ALumineMotus/LED_Cube_8x8x8_Mini/0_Documentation/Datasheet/Recto_verso_arduino_nano.jpg

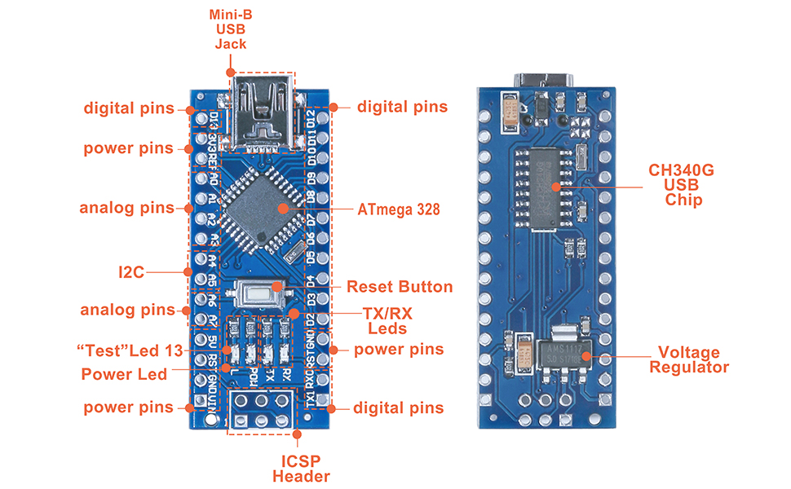
0_Documentation/Datasheet/Recto_verso_arduino_nano.jpg
