ALumineMotus/LED_Cube_8x8x8_Mini/1_Hardware/Cube_8x8x8_Mini_LED_Grid_08/Cube_Mini_8x8x8_LED_Grid_top_bom_NH-B1010RGBT-HF.csv

Comment | Designator | Footprint | LCSC Part #
NH-B1010RGBT-HF | U$1 | LED-ARRAY-SMD_4P-L1.0-W1.0-TR_NH-B1010RGBT | C2874113
NH-B1010RGBT-HF | U$2 | LED-ARRAY-SMD_4P-L1.0-W1.0-TR_NH-B1010RGBT | C2874113
NH-B1010RGBT-HF | U$3 | LED-ARRAY-SMD_4P-L1.0-W1.0-TR_NH-B1010RGBT | C2874113
NH-B1010RGBT-HF | U$4 | LED-ARRAY-SMD_4P-L1.0-W1.0-TR_NH-B1010RGBT | C2874113
NH-B1010RGBT-HF | U$5 | LED-ARRAY-SMD_4P-L1.0-W1.0-TR_NH-B1010RGBT | C2874113
NH-B1010RGBT-HF | U$6 | LED-ARRAY-SMD_4P-L1.0-W1.0-TR_NH-B1010RGBT | C2874113
NH-B1010RGBT-HF | U$7 | LED-ARRAY-SMD_4P-L1.0-W1.0-TR_NH-B1010RGBT | C2874113
NH-B1010RGBT-HF | U$8 | LED-ARRAY-SMD_4P-L1.0-W1.0-TR_NH-B1010RGBT | C2874113
NH-B1010RGBT-HF | U$9 | LED-ARRAY-SMD_4P-L1.0-W1.0-TR_NH-B1010RGBT | C2874113
NH-B1010RGBT-HF | U$10 | LED-ARRAY-SMD_4P-L1.0-W1.0-TR_NH-B1010RGBT | C2874113
NH-B1010RGBT-HF | U$11 | LED-ARRAY-SMD_4P-L1.0-W1.0-TR_NH-B1010RGBT | C2874113
NH-B1010RGBT-HF | U$12 | LED-ARRAY-SMD_4P-L1.0-W1.0-TR_NH-B1010RGBT | C2874113
NH-B1010RGBT-HF | U$13 | LED-ARRAY-SMD_4P-L1.0-W1.0-TR_NH-B1010RGBT | C2874113
NH-B1010RGBT-HF | U$14 | LED-ARRAY-SMD_4P-L1.0-W1.0-TR_NH-B1010RGBT | C2874113
NH-B1010RGBT-HF | U$15 | LED-ARRAY-SMD_4P-L1.0-W1.0-TR_NH-B1010RGBT | C2874113
NH-B1010RGBT-HF | U$16 | LED-ARRAY-SMD_4P-L1.0-W1.0-TR_NH-B1010RGBT | C2874113
NH-B1010RGBT-HF | U$17 | LED-ARRAY-SMD_4P-L1.0-W1.0-TR_NH-B1010RGBT | C2874113
NH-B1010RGBT-HF | U$18 | LED-ARRAY-SMD_4P-L1.0-W1.0-TR_NH-B1010RGBT | C2874113
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
NH-B1010RGBT-HF | U$62 | LED-ARRAY-SMD_4P-L1.0-W1.0-TR_NH-B1010RGBT | C2874113
NH-B1010RGBT-HF | U$63 | LED-ARRAY-SMD_4P-L1.0-W1.0-TR_NH-B1010RGBT | C2874113
NH-B1010RGBT-HF | U$64 | LED-ARRAY-SMD_4P-L1.0-W1.0-TR_NH-B1010RGBT | C2874113
