ALumineMotus/LED_Cube_8x8x8_Mini/3_Meca/glass_side_large.SLDPRT

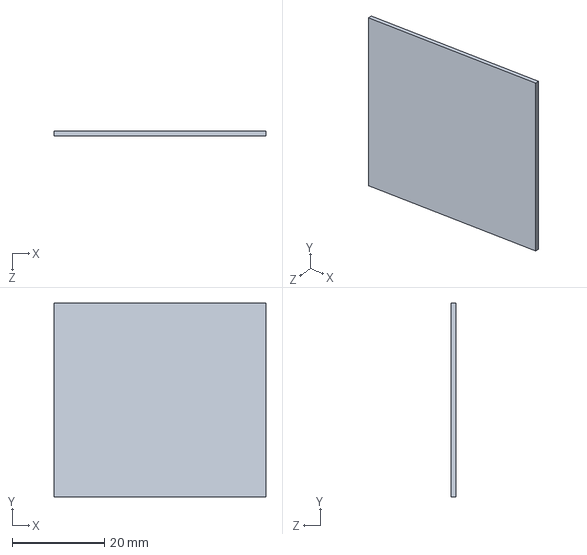
[picture p2: CAD file, 2024-05-30]
3_Meca/glass_side_large.SLDPRT
46.0 x 42.0 x 1.00 mm
