ALumineMotus/LED_Cube_8x8x8_Mini/3_Meca/glass_side_top.SLDPRT

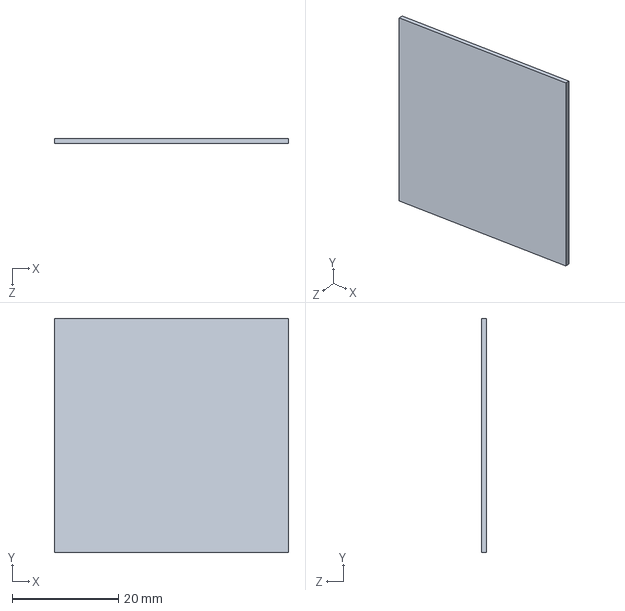
[picture p3: CAD file, 2024-05-30]
3_Meca/glass_side_top.SLDPRT
44.0 x 44.0 x 1.00 mm
