ALumineMotus/LED_Cube_8x8x8_Mini/3_Meca/glass_side_small.SLDPRT

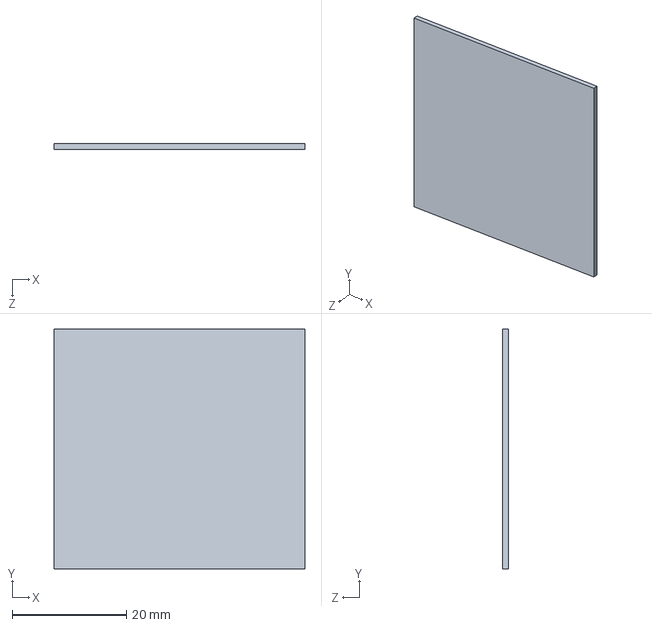
[picture p4: CAD file, 2024-05-30]
3_Meca/glass_side_small.SLDPRT
44.0 x 42.0 x 1.00 mm
