ALumineMotus/LED_Cube_8x8x8_Mini/3_Meca/case.SLDPRT

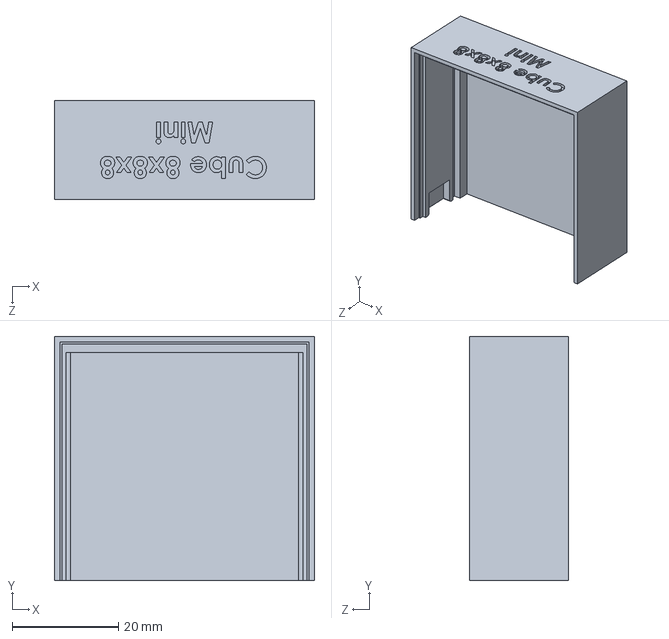
[picture p5: CAD file, 2024-01-14]
3_Meca/case.SLDPRT
49.0 x 46.0 x 18.6 mm
