ALumineMotus/LED_Cube_8x8x8_Mini/3_Meca/backside.SLDPRT

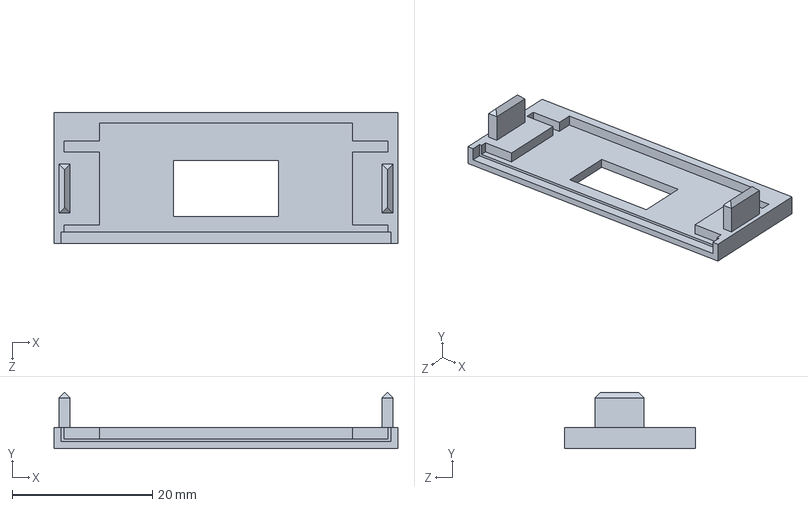
[picture p6: CAD file, 2024-01-14]
3_Meca/backside.SLDPRT
49.0 x 8.00 x 18.6 mm
