ALumineMotus/LED_Cube_8x8x8_Mini/3_Meca/cale.SLDPRT

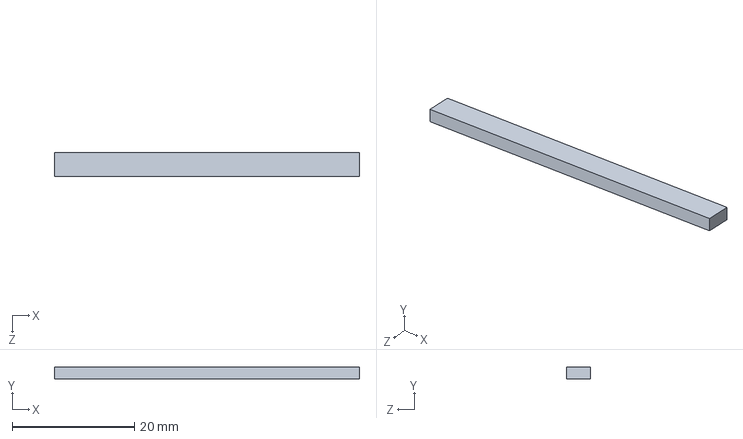
[picture p7: CAD file, 2024-01-14]
3_Meca/cale.SLDPRT
50.0 x 2.00 x 4.00 mm
