ALumineMotus/LED_Cube_8x8x8_Mini/(list of files, cad)

Other CAD files:
3_Meca/backside.STL
3_Meca/cale.STL
3_Meca/case.STL
3_Meca/glass_side_large.dxf
3_Meca/glass_side_small.dxf
3_Meca/glass_side_top.dxf
