ALumineMotus/LED_Cube_8x8x8_Mini/0_Documentation/Schematic/Cube_8x8x8_Mini_LED_Base_Schematic.pdf

A

A

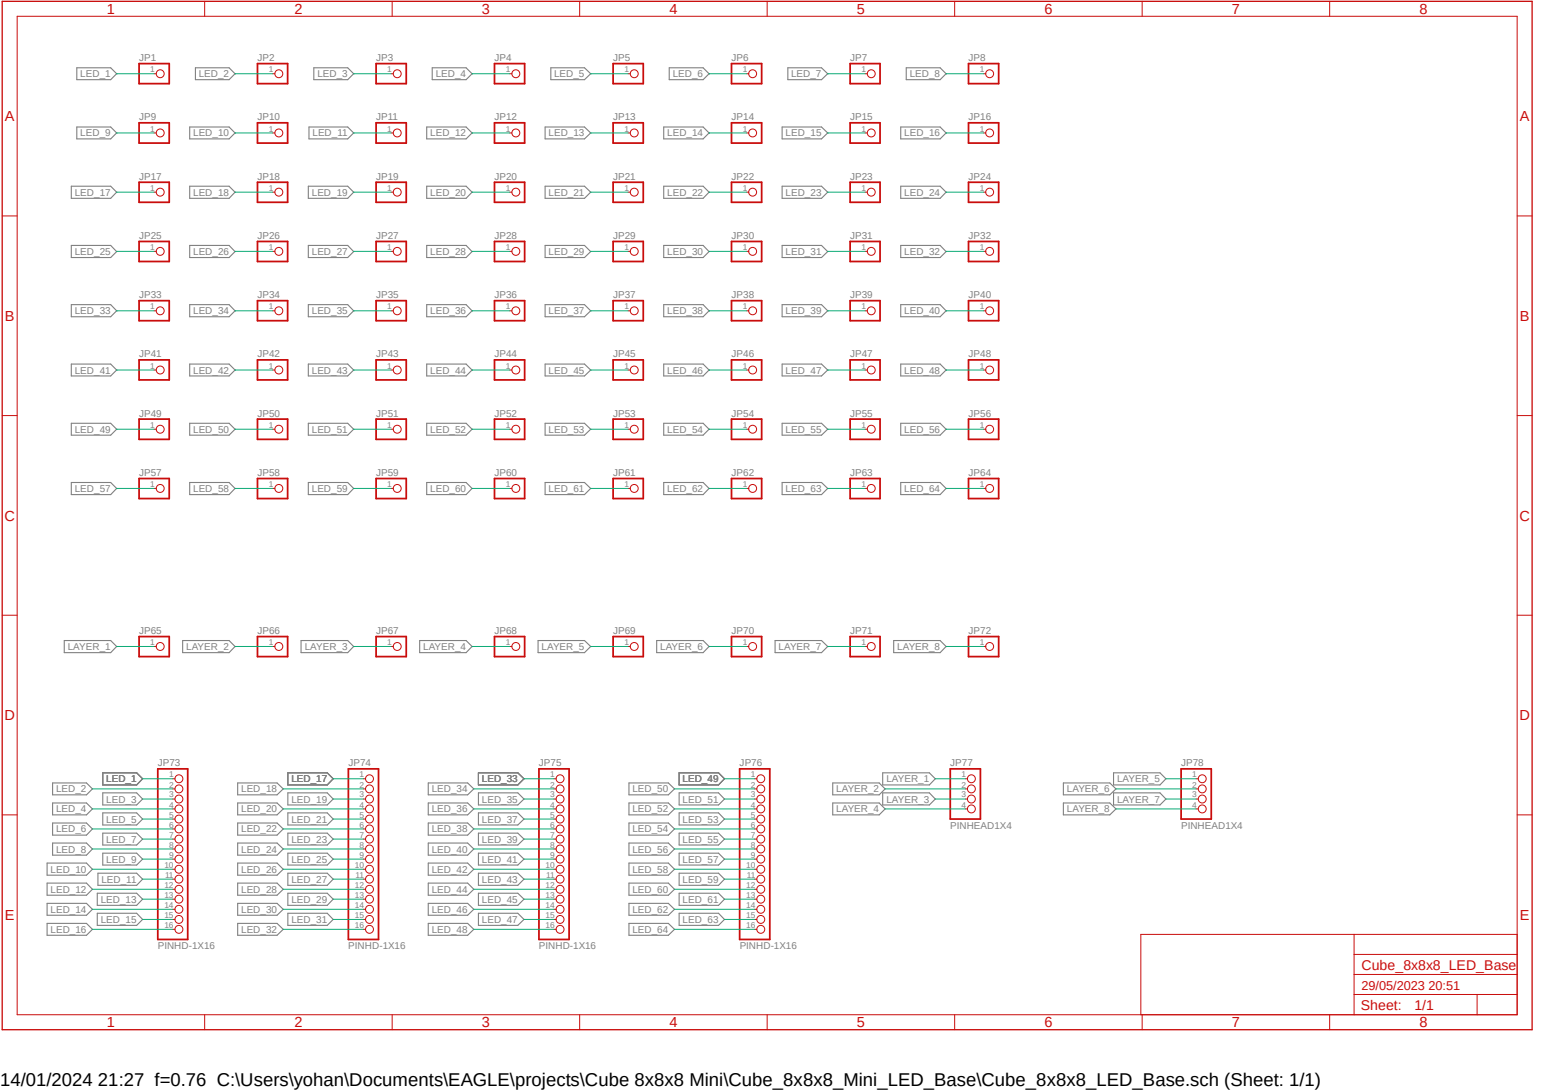
[picture p9: page 1]

14/01/2024 21:27 f=0.76 C:\Users\yohan\Documents\EAGLE\projects\Cube 8x8x8 Mini\Cube_8x8x8_Mini_LED_Base\Cube_8x8x8_LED_Base.sch (Sheet: 1/1)
