ALumineMotus/LED_Cube_8x8x8_Mini/0_Documentation/Schematic/Cube_8x8x8_Mini_LED_Grid_08_Schematic.pdf

A

B

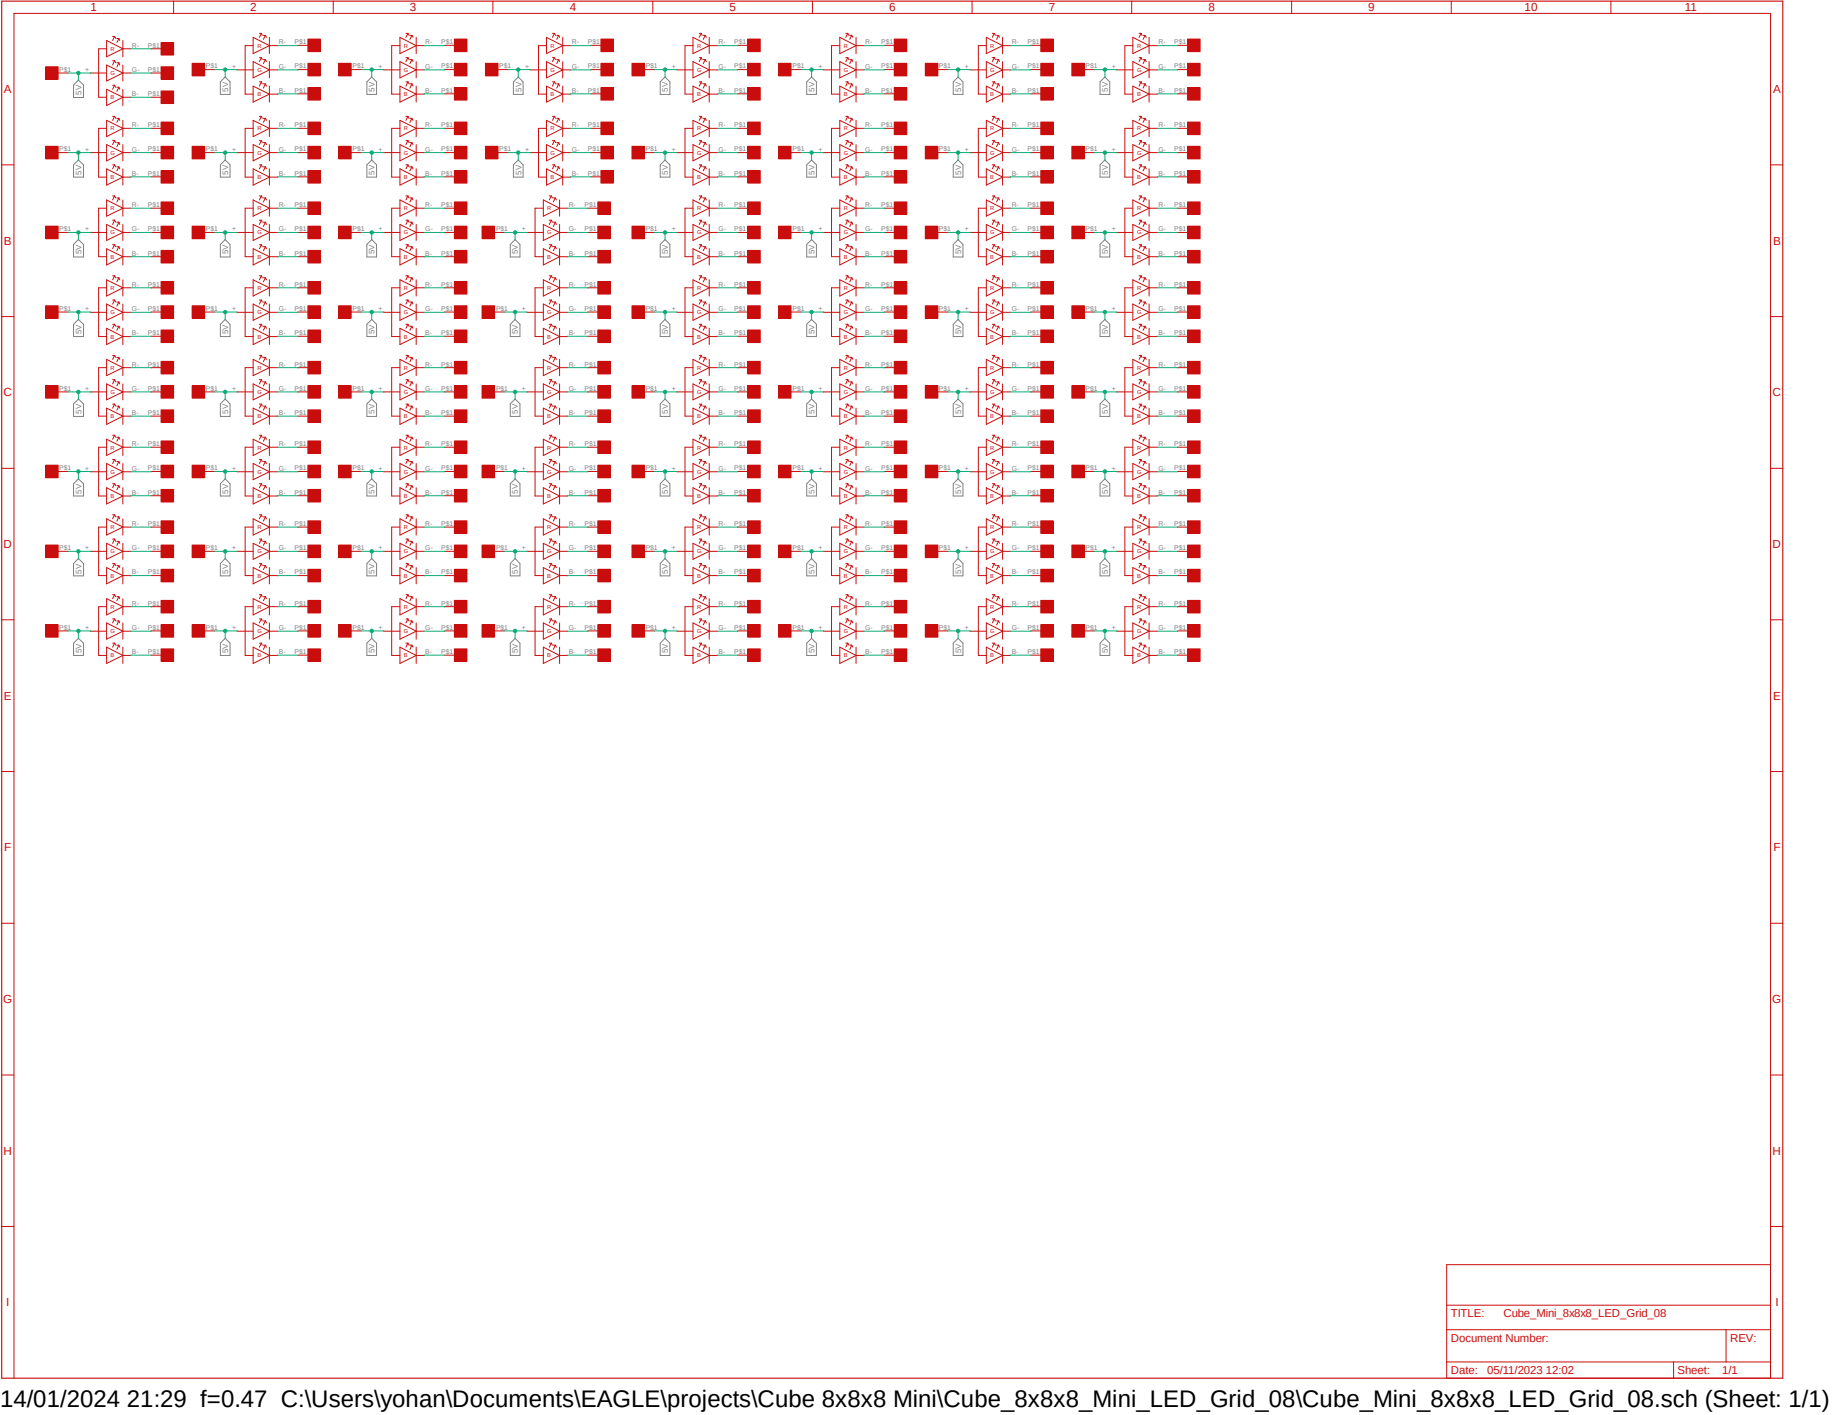
[picture p10: page 1]
TITLE:; Cube_Mini_8x8x8_LED_Grid_08

Document Number: | REV:

Date: 05/11/2023 12:02 | Sheet: 1/1

14/01/2024 21:29 f=0.47 C:\Users\yohan\Documents\EAGLE\projects\Cube 8x8x8 Mini\Cube_8x8x8_Mini_LED_Grid_08\Cube_Mini_8x8x8_LED_Grid_08.sch (Sheet: 1/1)
