ALumineMotus/LED_Cube_8x8x8_Mini/1_Hardware/Fail/Cube 8x8x8 Mini - Control - Copie/Cube_8x8x8_Mini_Control.brd

## EAGLE design 1_Hardware/Fail/Cube 8x8x8 Mini - Control - Copie/Cube_8x8x8_Mini_Control.brd (2024-05-30)

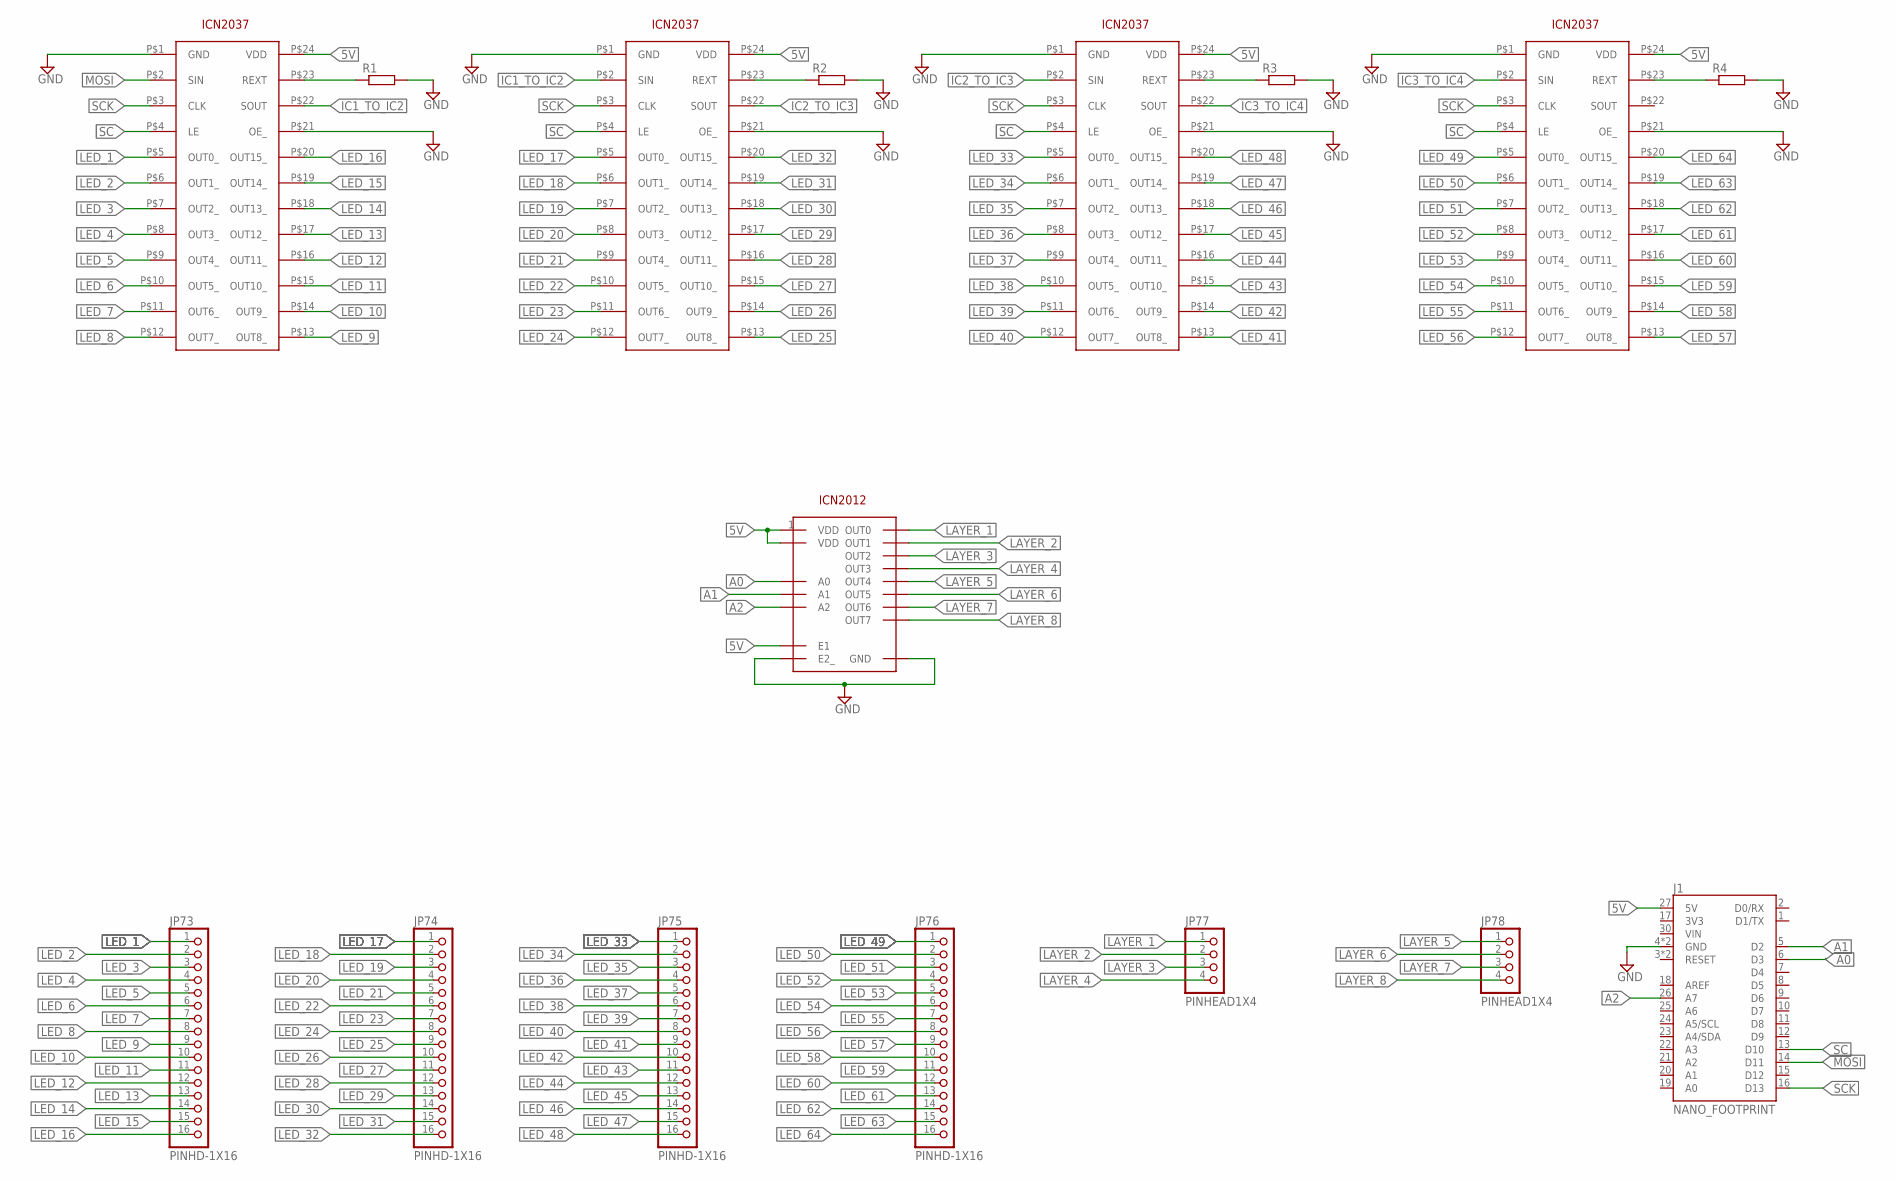
[picture p11: schematic Cube_8x8x8_Mini_Control.sch]

Parts:
J1: NANO_FOOTPRINT; NANO
JP73, JP74, JP75, JP76: PINHD-1X16; 2X16
JP77, JP78: PINHEAD1X4; 2X04
R1, R2, R3, R4: R-EU_R1206; R1206
U1, U2, U3, U4: ICN2037; SSOP24-P-150-0.635
U5: ICN2012; SOP16

Connections:
5V: J1.27 (5V), U1.P$24 (VDD), U2.P$24 (VDD), U3.P$24 (VDD), U4.P$24 (VDD), U5.1 (VDD), U5.7 (E1), U5.9 (VDD)
A0: J1.6 (D3), U5.15 (A0)
A1: J1.5 (D2), U5.16 (A1)
A2: J1.26 (A7), U5.2 (A2)
GND: J1.4 (GND), J1.29 (GND), R1.2, R2.2, R3.2, R4.2, U1.P$1 (GND), U1.P$21 (OE_), U2.P$1 (GND), U2.P$21 (OE_), U3.P$1 (GND), U3.P$21 (OE_), U4.P$1 (GND), U4.P$21 (OE_), U5.8 (GND), U5.10 (E2_)
IC1_TO_IC2: U1.P$22 (SOUT), U2.P$2 (SIN)
IC2_TO_IC3: U2.P$22 (SOUT), U3.P$2 (SIN)
IC3_TO_IC4: U3.P$22 (SOUT), U4.P$2 (SIN)
LAYER_1: JP77.1, U5.3 (OUT0)
LAYER_2: JP77.2, U5.4 (OUT1)
LAYER_3: JP77.3, U5.5 (OUT2)
LAYER_4: JP77.4, U5.6 (OUT3)
LAYER_5: JP78.1, U5.11 (OUT4)
LAYER_6: JP78.2, U5.12 (OUT5)
LAYER_7: JP78.3, U5.13 (OUT6)
LAYER_8: JP78.4, U5.14 (OUT7)
LED_1: JP73.1, U1.P$5 (OUT0_)
LED_2: JP73.2, U1.P$6 (OUT1_)
LED_3: JP73.3, U1.P$7 (OUT2_)
LED_4: JP73.4, U1.P$8 (OUT3_)
LED_5: JP73.5, U1.P$9 (OUT4_)
LED_6: JP73.6, U1.P$10 (OUT5_)
LED_7: JP73.7, U1.P$11 (OUT6_)
LED_8: JP73.8, U1.P$12 (OUT7_)
LED_9: JP73.9, U1.P$13 (OUT8_)
LED_10: JP73.10, U1.P$14 (OUT9_)
LED_11: JP73.11, U1.P$15 (OUT10_)
LED_12: JP73.12, U1.P$16 (OUT11_)
LED_13: JP73.13, U1.P$17 (OUT12_)
LED_14: JP73.14, U1.P$18 (OUT13_)
LED_15: JP73.15, U1.P$19 (OUT14_)
LED_16: JP73.16, U1.P$20 (OUT15_)
LED_17: JP74.1, U2.P$5 (OUT0_)
LED_18: JP74.2, U2.P$6 (OUT1_)
LED_19: JP74.3, U2.P$7 (OUT2_)
LED_20: JP74.4, U2.P$8 (OUT3_)
LED_21: JP74.5, U2.P$9 (OUT4_)
LED_22: JP74.6, U2.P$10 (OUT5_)
LED_23: JP74.7, U2.P$11 (OUT6_)
LED_24: JP74.8, U2.P$12 (OUT7_)
LED_25: JP74.9, U2.P$13 (OUT8_)
LED_26: JP74.10, U2.P$14 (OUT9_)
LED_27: JP74.11, U2.P$15 (OUT10_)
LED_28: JP74.12, U2.P$16 (OUT11_)
LED_29: JP74.13, U2.P$17 (OUT12_)
LED_30: JP74.14, U2.P$18 (OUT13_)
LED_31: JP74.15, U2.P$19 (OUT14_)
LED_32: JP74.16, U2.P$20 (OUT15_)
LED_33: JP75.1, U3.P$5 (OUT0_)
LED_34: JP75.2, U3.P$6 (OUT1_)
LED_35: JP75.3, U3.P$7 (OUT2_)
LED_36: JP75.4, U3.P$8 (OUT3_)
LED_37: JP75.5, U3.P$9 (OUT4_)
LED_38: JP75.6, U3.P$10 (OUT5_)
LED_39: JP75.7, U3.P$11 (OUT6_)
LED_40: JP75.8, U3.P$12 (OUT7_)
LED_41: JP75.9, U3.P$13 (OUT8_)
LED_42: JP75.10, U3.P$14 (OUT9_)
LED_43: JP75.11, U3.P$15 (OUT10_)
LED_44: JP75.12, U3.P$16 (OUT11_)
LED_45: JP75.13, U3.P$17 (OUT12_)
LED_46: JP75.14, U3.P$18 (OUT13_)
LED_47: JP75.15, U3.P$19 (OUT14_)
LED_48: JP75.16, U3.P$20 (OUT15_)
LED_49: JP76.1, U4.P$5 (OUT0_)
LED_50: JP76.2, U4.P$6 (OUT1_)
LED_51: JP76.3, U4.P$7 (OUT2_)
LED_52: JP76.4, U4.P$8 (OUT3_)
LED_53: JP76.5, U4.P$9 (OUT4_)
LED_54: JP76.6, U4.P$10 (OUT5_)
LED_55: JP76.7, U4.P$11 (OUT6_)
LED_56: JP76.8, U4.P$12 (OUT7_)
LED_57: JP76.9, U4.P$13 (OUT8_)
LED_58: JP76.10, U4.P$14 (OUT9_)
LED_59: JP76.11, U4.P$15 (OUT10_)
LED_60: JP76.12, U4.P$16 (OUT11_)
LED_61: JP76.13, U4.P$17 (OUT12_)
LED_62: JP76.14, U4.P$18 (OUT13_)
LED_63: JP76.15, U4.P$19 (OUT14_)
LED_64: JP76.16, U4.P$20 (OUT15_)
MOSI: J1.14 (D11), U1.P$2 (SIN)
unnamed: R1.1, U1.P$23 (REXT)
unnamed: R2.1, U2.P$23 (REXT)
unnamed: R3.1, U3.P$23 (REXT)
unnamed: R4.1, U4.P$23 (REXT)
SC: J1.13 (D10), U1.P$4 (LE), U2.P$4 (LE), U3.P$4 (LE), U4.P$4 (LE)
SCK: J1.16 (D13), U1.P$3 (CLK), U2.P$3 (CLK), U3.P$3 (CLK), U4.P$3 (CLK)

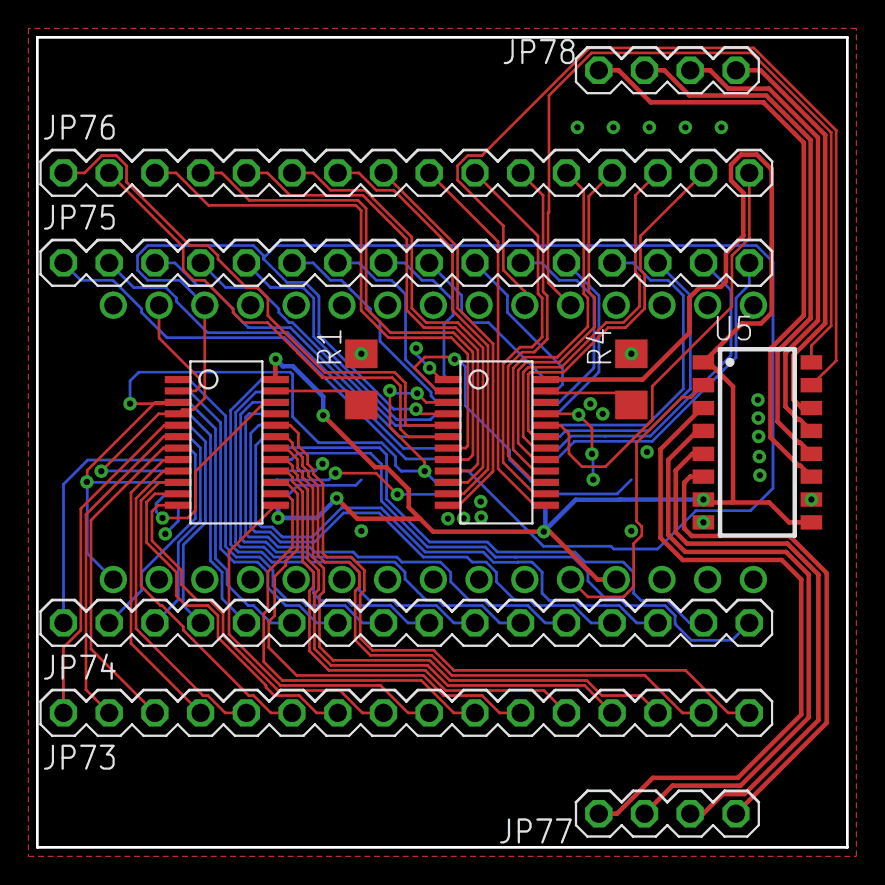
[picture p12: board Cube_8x8x8_Mini_Control.brd from above]

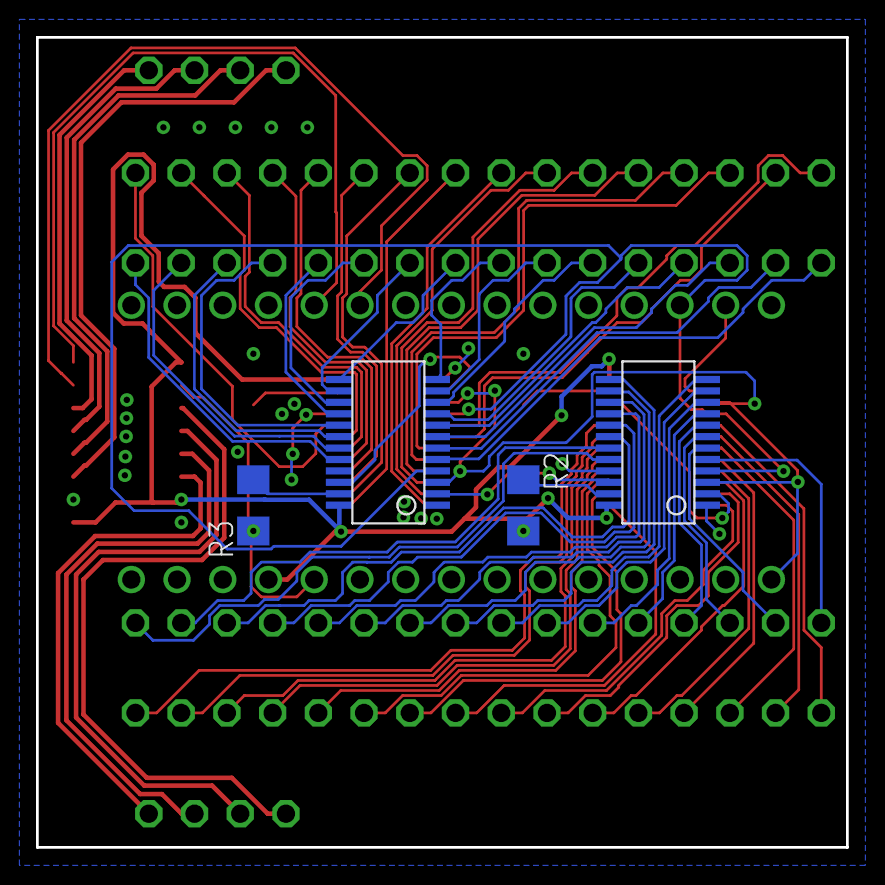
[picture p13: board Cube_8x8x8_Mini_Control.brd from below]

Board: 2 copper layers, 45.0 x 45.0 mm, 16 parts (4 on the bottom side), 87 nets.
