ALumineMotus/LED_Cube_8x8x8_Mini/1_Hardware/Cube_8x8x8_Mini_LED_Grid_08/Cube_Mini_8x8x8_LED_Grid_08.brd

## EAGLE design 1_Hardware/Cube_8x8x8_Mini_LED_Grid_08/Cube_Mini_8x8x8_LED_Grid_08.brd (2024-01-14)

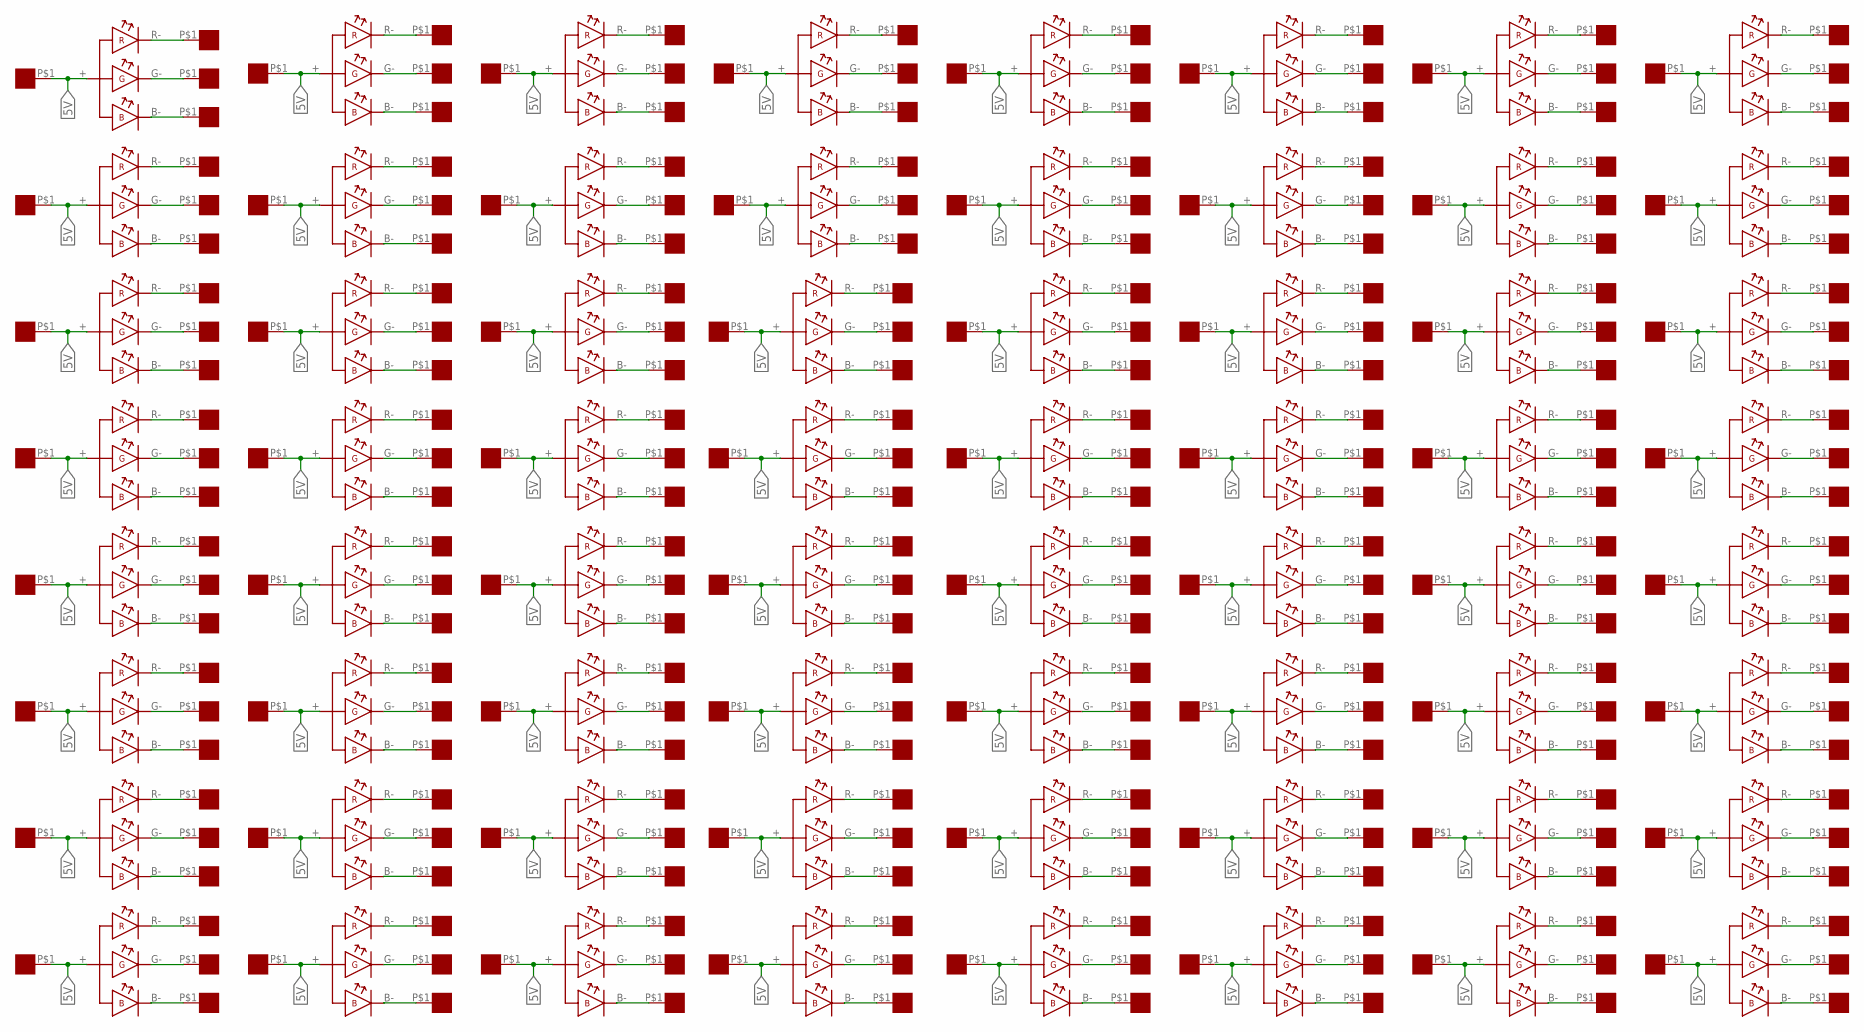
[picture p14: schematic Cube_Mini_8x8x8_LED_Grid_08.sch]

Parts:
5V$1, 5V$2, 5V$3, 5V$4, 5V$5, 5V$6, 5V$7, 5V$8, 5V$9, 5V$10, 5V$11, 5V$12, 5V$13, 5V$14, 5V$15, 5V$16, 5V$17, 5V$18, 5V$19, 5V$20, 5V$21, 5V$22, 5V$23, 5V$24, 5V$25, 5V$26, 5V$27, 5V$28, 5V$29, 5V$30, 5V$31, 5V$32, 5V$33, 5V$34, 5V$35, 5V$36, 5V$37, 5V$38, 5V$39, 5V$40, 5V$41, 5V$42, 5V$43, 5V$44, 5V$45, 5V$46, 5V$47, 5V$48, 5V$49, 5V$50, 5V$51, 5V$52, 5V$53, 5V$54, 5V$55, 5V$56, 5V$57, 5V$58, 5V$59, 5V$60, 5V$61, 5V$62, 5V$63, 5V$64: 05X08PAD
B$1, B$2, B$3, B$4, B$5, B$6, B$7, B$8, B$9, B$10, B$11, B$12, B$13, B$14, B$15, B$16, B$17, B$18, B$19, B$20, B$21, B$22, B$23, B$24, B$25, B$26, B$27, B$28, B$29, B$30, B$31, B$32, B$33, B$34, B$35, B$36, B$37, B$38, B$39, B$40, B$41, B$42, B$43, B$44, B$45, B$46, B$47, B$48, B$49, B$50, B$51, B$52, B$53, B$54, B$55, B$56, B$57, B$58, B$59, B$60, B$61, B$62, B$63, B$64: 05X08PAD
G$1, G$2, G$3, G$4, G$5, G$6, G$7, G$8, G$9, G$10, G$11, G$12, G$13, G$14, G$15, G$16, G$17, G$18, G$19, G$20, G$21, G$22, G$23, G$24, G$25, G$26, G$27, G$28, G$29, G$30, G$31, G$32, G$33, G$34, G$35, G$36, G$37, G$38, G$39, G$40, G$41, G$42, G$43, G$44, G$45, G$46, G$47, G$48, G$49, G$50, G$51, G$52, G$53, G$54, G$55, G$56, G$57, G$58, G$59, G$60, G$61, G$62, G$63, G$64: 05X08PAD
R$1, R$2, R$3, R$4, R$5, R$6, R$7, R$8, R$9, R$10, R$11, R$12, R$13, R$14, R$15, R$16, R$17, R$18, R$19, R$20, R$21, R$22, R$23, R$24, R$25, R$26, R$27, R$28, R$29, R$30, R$31, R$32, R$33, R$34, R$35, R$36, R$37, R$38, R$39, R$40, R$41, R$42, R$43, R$44, R$45, R$46, R$47, R$48, R$49, R$50, R$51, R$52, R$53, R$54, R$55, R$56, R$57, R$58, R$59, R$60, R$61, R$62, R$63, R$64: 05X08PAD
U$1, U$2, U$3, U$4, U$5, U$6, U$7, U$8, U$9, U$10, U$11, U$12, U$13, U$14, U$15, U$16, U$17, U$18, U$19, U$20, U$21, U$22, U$23, U$24, U$25, U$26, U$27, U$28, U$29, U$30, U$31, U$32, U$33, U$34, U$35, U$36, U$37, U$38, U$39, U$40, U$41, U$42, U$43, U$44, U$45, U$46, U$47, U$48, U$49, U$50, U$51, U$52, U$53, U$54, U$55, U$56, U$57, U$58, U$59, U$60, U$61, U$62, U$63, U$64: B1010RGBT

Connections:
5V: 5V$1.P$1, 5V$2.P$1, 5V$3.P$1, 5V$4.P$1, 5V$5.P$1, 5V$6.P$1, 5V$7.P$1, 5V$8.P$1, 5V$9.P$1, 5V$10.P$1, 5V$11.P$1, 5V$12.P$1, 5V$13.P$1, 5V$14.P$1, 5V$15.P$1, 5V$16.P$1, 5V$17.P$1, 5V$18.P$1, 5V$19.P$1, 5V$20.P$1, 5V$21.P$1, 5V$22.P$1, 5V$23.P$1, 5V$24.P$1, 5V$25.P$1, 5V$26.P$1, 5V$27.P$1, 5V$28.P$1, 5V$29.P$1, 5V$30.P$1, 5V$31.P$1, 5V$32.P$1, 5V$33.P$1, 5V$34.P$1, 5V$35.P$1, 5V$36.P$1, 5V$37.P$1, 5V$38.P$1, 5V$39.P$1, 5V$40.P$1, 5V$41.P$1, 5V$42.P$1, 5V$43.P$1, 5V$44.P$1, 5V$45.P$1, 5V$46.P$1, 5V$47.P$1, 5V$48.P$1, 5V$49.P$1, 5V$50.P$1, 5V$51.P$1, 5V$52.P$1, 5V$53.P$1, 5V$54.P$1, 5V$55.P$1, 5V$56.P$1, 5V$57.P$1, 5V$58.P$1, 5V$59.P$1, 5V$60.P$1, 5V$61.P$1, 5V$62.P$1, 5V$63.P$1, 5V$64.P$1, U$1.+, U$2.+, U$3.+, U$4.+, U$5.+, U$6.+, U$7.+, U$8.+, U$9.+, U$10.+, U$11.+, U$12.+, U$13.+, U$14.+, U$15.+, U$16.+, U$17.+, U$18.+, U$19.+, U$20.+, U$21.+, U$22.+, U$23.+, U$24.+, U$25.+, U$26.+, U$27.+, U$28.+, U$29.+, U$30.+, U$31.+, U$32.+, U$33.+, U$34.+, U$35.+, U$36.+, U$37.+, U$38.+, U$39.+, U$40.+, U$41.+, U$42.+, U$43.+, U$44.+, U$45.+, U$46.+, U$47.+, U$48.+, U$49.+, U$50.+, U$51.+, U$52.+, U$53.+, U$54.+, U$55.+, U$56.+, U$57.+, U$58.+, U$59.+, U$60.+, U$61.+, U$62.+, U$63.+, U$64.+
unnamed: R$1.P$1, U$1.R-
unnamed: G$1.P$1, U$1.G-
unnamed: B$1.P$1, U$1.B-
unnamed: R$2.P$1, U$2.R-
unnamed: G$2.P$1, U$2.G-
unnamed: B$2.P$1, U$2.B-
unnamed: R$3.P$1, U$3.R-
unnamed: G$3.P$1, U$3.G-
unnamed: B$3.P$1, U$3.B-
unnamed: R$5.P$1, U$5.R-
unnamed: G$5.P$1, U$5.G-
unnamed: B$5.P$1, U$5.B-
unnamed: R$4.P$1, U$4.R-
unnamed: G$4.P$1, U$4.G-
unnamed: B$4.P$1, U$4.B-
unnamed: R$7.P$1, U$7.R-
unnamed: G$7.P$1, U$7.G-
unnamed: B$7.P$1, U$7.B-
unnamed: R$6.P$1, U$6.R-
unnamed: G$6.P$1, U$6.G-
unnamed: B$6.P$1, U$6.B-
unnamed: R$9.P$1, U$9.R-
unnamed: G$9.P$1, U$9.G-
unnamed: B$9.P$1, U$9.B-
unnamed: R$8.P$1, U$8.R-
unnamed: G$8.P$1, U$8.G-
unnamed: B$8.P$1, U$8.B-
unnamed: R$11.P$1, U$11.R-
unnamed: G$11.P$1, U$11.G-
unnamed: B$11.P$1, U$11.B-
unnamed: R$10.P$1, U$10.R-
unnamed: G$10.P$1, U$10.G-
unnamed: B$10.P$1, U$10.B-
unnamed: R$12.P$1, U$12.R-
unnamed: G$12.P$1, U$12.G-
unnamed: B$12.P$1, U$12.B-
unnamed: R$13.P$1, U$13.R-
unnamed: G$13.P$1, U$13.G-
unnamed: B$13.P$1, U$13.B-
unnamed: R$14.P$1, U$14.R-
unnamed: G$14.P$1, U$14.G-
unnamed: B$14.P$1, U$14.B-
unnamed: R$15.P$1, U$15.R-
unnamed: G$15.P$1, U$15.G-
unnamed: B$15.P$1, U$15.B-
unnamed: R$16.P$1, U$16.R-
unnamed: G$16.P$1, U$16.G-
unnamed: B$16.P$1, U$16.B-
unnamed: R$17.P$1, U$17.R-
unnamed: G$17.P$1, U$17.G-
unnamed: B$17.P$1, U$17.B-
unnamed: R$18.P$1, U$18.R-
unnamed: G$18.P$1, U$18.G-
unnamed: B$18.P$1, U$18.B-
unnamed: R$19.P$1, U$19.R-
unnamed: G$19.P$1, U$19.G-
unnamed: B$19.P$1, U$19.B-
unnamed: R$20.P$1, U$20.R-
unnamed: G$20.P$1, U$20.G-
unnamed: B$20.P$1, U$20.B-
unnamed: R$21.P$1, U$21.R-
unnamed: G$21.P$1, U$21.G-
unnamed: B$21.P$1, U$21.B-
unnamed: R$22.P$1, U$22.R-
unnamed: G$22.P$1, U$22.G-
unnamed: B$22.P$1, U$22.B-
unnamed: R$23.P$1, U$23.R-
unnamed: G$23.P$1, U$23.G-
unnamed: B$23.P$1, U$23.B-
unnamed: R$24.P$1, U$24.R-
unnamed: G$24.P$1, U$24.G-
unnamed: B$24.P$1, U$24.B-
unnamed: R$25.P$1, U$25.R-
unnamed: G$25.P$1, U$25.G-
unnamed: B$25.P$1, U$25.B-
unnamed: R$26.P$1, U$26.R-
unnamed: G$26.P$1, U$26.G-
unnamed: B$26.P$1, U$26.B-
unnamed: R$27.P$1, U$27.R-
unnamed: G$27.P$1, U$27.G-
unnamed: B$27.P$1, U$27.B-
unnamed: R$28.P$1, U$28.R-
unnamed: G$28.P$1, U$28.G-
unnamed: B$28.P$1, U$28.B-
unnamed: R$29.P$1, U$29.R-
unnamed: G$29.P$1, U$29.G-
unnamed: B$29.P$1, U$29.B-
unnamed: R$30.P$1, U$30.R-
unnamed: G$30.P$1, U$30.G-
unnamed: B$30.P$1, U$30.B-
unnamed: R$31.P$1, U$31.R-
unnamed: G$31.P$1, U$31.G-
unnamed: B$31.P$1, U$31.B-
unnamed: R$32.P$1, U$32.R-
unnamed: G$32.P$1, U$32.G-
unnamed: B$32.P$1, U$32.B-
unnamed: R$33.P$1, U$33.R-
unnamed: G$33.P$1, U$33.G-
unnamed: B$33.P$1, U$33.B-
unnamed: R$34.P$1, U$34.R-
unnamed: G$34.P$1, U$34.G-
unnamed: B$34.P$1, U$34.B-
unnamed: R$35.P$1, U$35.R-
unnamed: G$35.P$1, U$35.G-
unnamed: B$35.P$1, U$35.B-
unnamed: R$36.P$1, U$36.R-
unnamed: G$36.P$1, U$36.G-
unnamed: B$36.P$1, U$36.B-
unnamed: R$38.P$1, U$38.R-
unnamed: G$38.P$1, U$38.G-
unnamed: B$38.P$1, U$38.B-
unnamed: R$37.P$1, U$37.R-
unnamed: G$37.P$1, U$37.G-
unnamed: B$37.P$1, U$37.B-
unnamed: R$39.P$1, U$39.R-
unnamed: G$39.P$1, U$39.G-
unnamed: B$39.P$1, U$39.B-
unnamed: R$40.P$1, U$40.R-
unnamed: G$40.P$1, U$40.G-
unnamed: B$40.P$1, U$40.B-
unnamed: R$41.P$1, U$41.R-
unnamed: G$41.P$1, U$41.G-
unnamed: B$41.P$1, U$41.B-
unnamed: R$42.P$1, U$42.R-
unnamed: G$42.P$1, U$42.G-
unnamed: B$42.P$1, U$42.B-
unnamed: R$44.P$1, U$44.R-
unnamed: G$44.P$1, U$44.G-
unnamed: B$44.P$1, U$44.B-
unnamed: R$43.P$1, U$43.R-
unnamed: G$43.P$1, U$43.G-
unnamed: B$43.P$1, U$43.B-
unnamed: R$45.P$1, U$45.R-
unnamed: G$45.P$1, U$45.G-
unnamed: B$45.P$1, U$45.B-
unnamed: R$46.P$1, U$46.R-
unnamed: G$46.P$1, U$46.G-
unnamed: B$46.P$1, U$46.B-
unnamed: R$47.P$1, U$47.R-
unnamed: G$47.P$1, U$47.G-
unnamed: B$47.P$1, U$47.B-
unnamed: R$48.P$1, U$48.R-
unnamed: G$48.P$1, U$48.G-
unnamed: B$48.P$1, U$48.B-
unnamed: R$50.P$1, U$50.R-
unnamed: G$50.P$1, U$50.G-
unnamed: B$50.P$1, U$50.B-
unnamed: R$49.P$1, U$49.R-
unnamed: G$49.P$1, U$49.G-
unnamed: B$49.P$1, U$49.B-
unnamed: R$51.P$1, U$51.R-
unnamed: G$51.P$1, U$51.G-
unnamed: B$51.P$1, U$51.B-
unnamed: R$53.P$1, U$53.R-
unnamed: G$53.P$1, U$53.G-
unnamed: B$53.P$1, U$53.B-
unnamed: R$52.P$1, U$52.R-
unnamed: G$52.P$1, U$52.G-
unnamed: B$52.P$1, U$52.B-
unnamed: R$54.P$1, U$54.R-
unnamed: G$54.P$1, U$54.G-
unnamed: B$54.P$1, U$54.B-
unnamed: R$55.P$1, U$55.R-
unnamed: G$55.P$1, U$55.G-
unnamed: B$55.P$1, U$55.B-
unnamed: R$56.P$1, U$56.R-
unnamed: G$56.P$1, U$56.G-
unnamed: B$56.P$1, U$56.B-
unnamed: R$58.P$1, U$58.R-
unnamed: G$58.P$1, U$58.G-
unnamed: B$58.P$1, U$58.B-
unnamed: R$57.P$1, U$57.R-
unnamed: G$57.P$1, U$57.G-
unnamed: B$57.P$1, U$57.B-
unnamed: R$59.P$1, U$59.R-
unnamed: G$59.P$1, U$59.G-
unnamed: B$59.P$1, U$59.B-
unnamed: R$60.P$1, U$60.R-
unnamed: G$60.P$1, U$60.G-
unnamed: B$60.P$1, U$60.B-
unnamed: R$61.P$1, U$61.R-
unnamed: G$61.P$1, U$61.G-
unnamed: B$61.P$1, U$61.B-
unnamed: R$62.P$1, U$62.R-
unnamed: G$62.P$1, U$62.G-
unnamed: B$62.P$1, U$62.B-
unnamed: R$63.P$1, U$63.R-
unnamed: G$63.P$1, U$63.G-
unnamed: B$63.P$1, U$63.B-
unnamed: R$64.P$1, U$64.R-
unnamed: G$64.P$1, U$64.G-
unnamed: B$64.P$1, U$64.B-

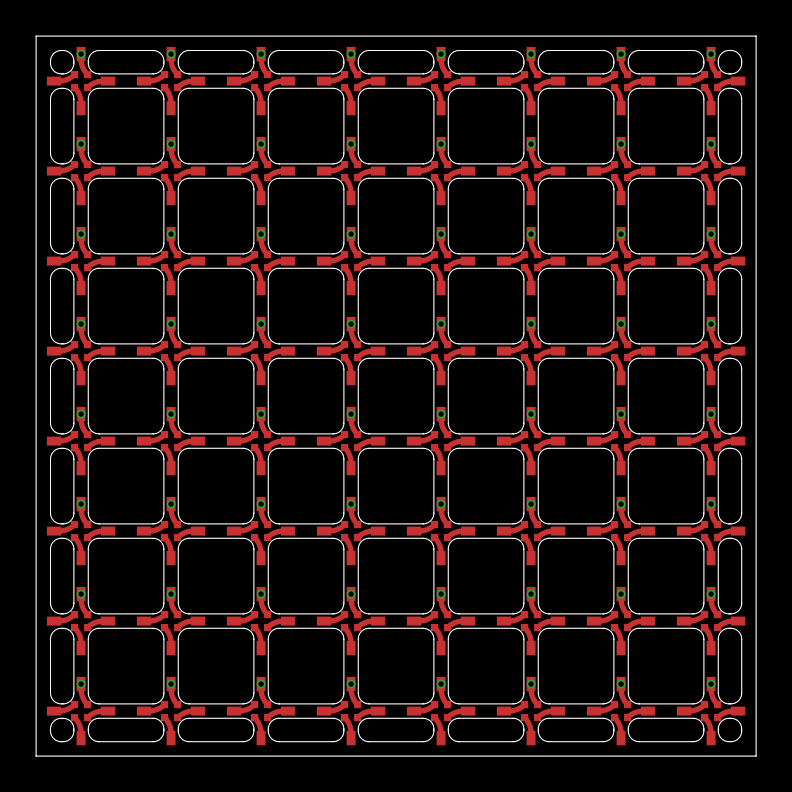
[picture p15: board Cube_Mini_8x8x8_LED_Grid_08.brd from above]

Board: 2 copper layers, 40.0 x 40.0 mm, 320 parts (0 on the bottom side), 193 nets.
