ALumineMotus/LED_Cube_8x8x8_Mini/1_Hardware/Cube_8x8x8_Mini_LED_Base/Cube_8x8x8_LED_Base.brd

## EAGLE design 1_Hardware/Cube_8x8x8_Mini_LED_Base/Cube_8x8x8_LED_Base.brd (2024-01-14)

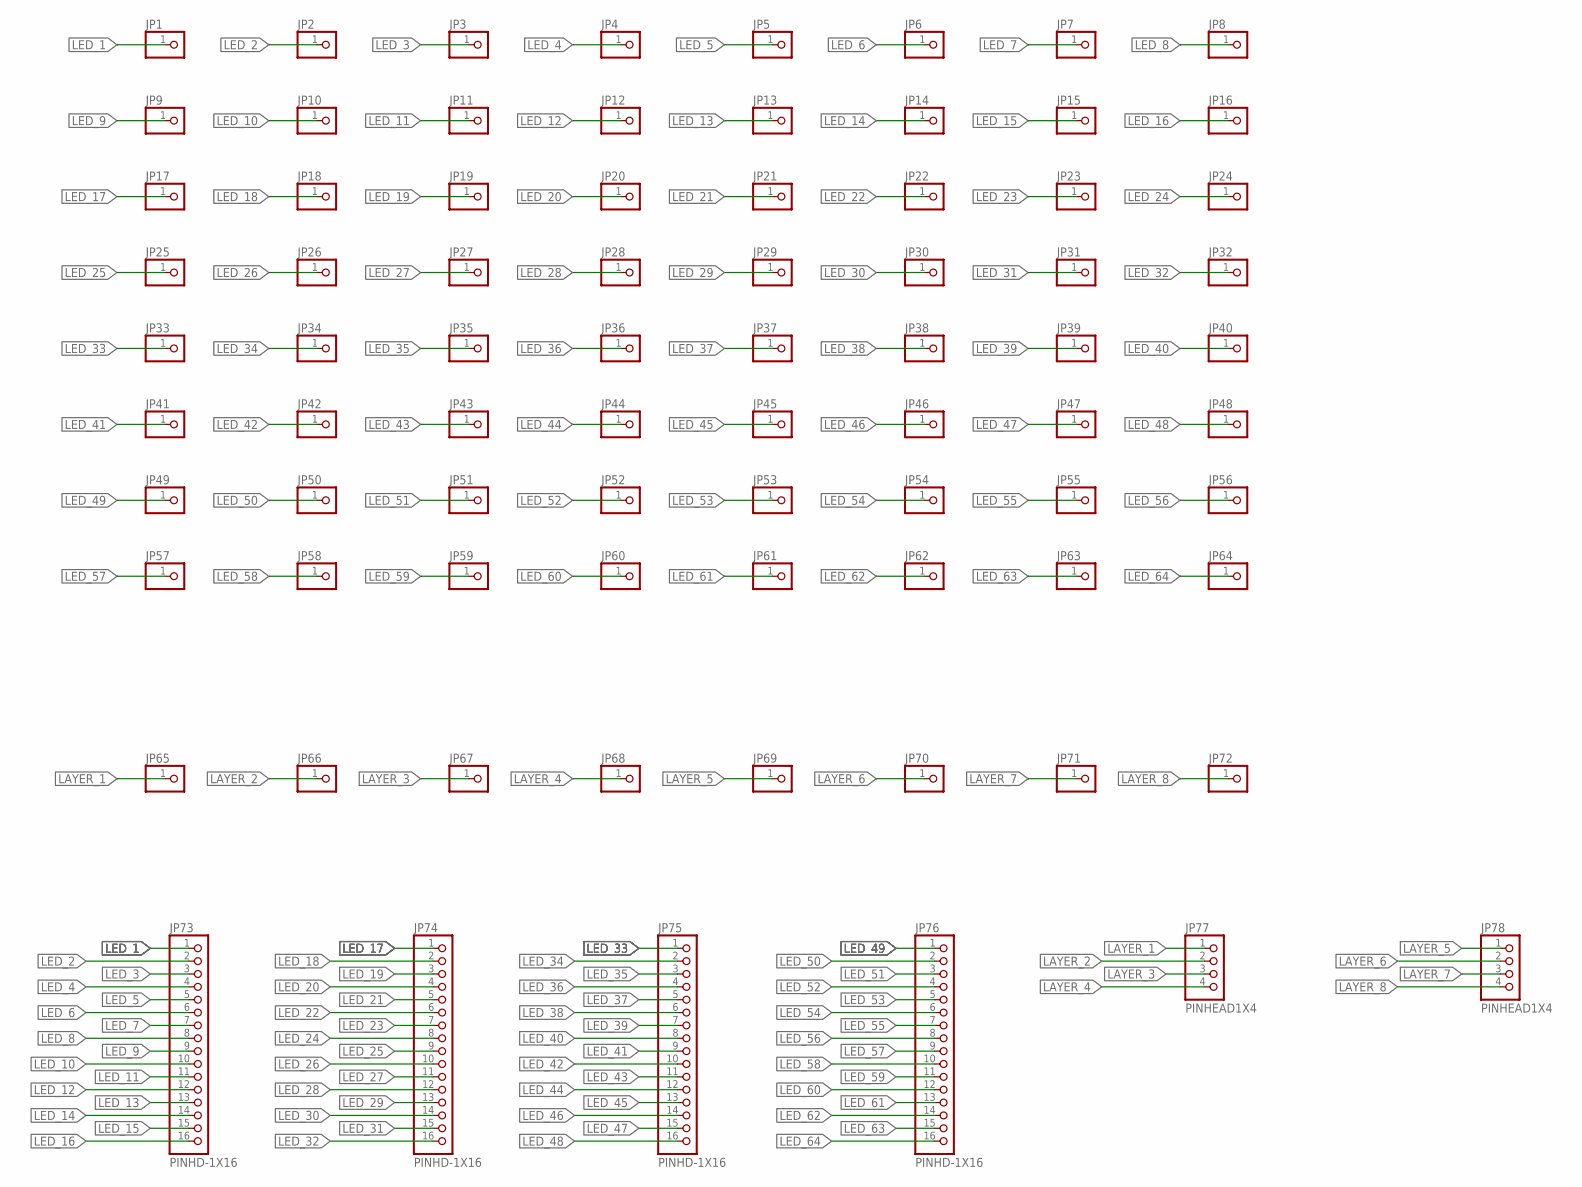
[picture p16: schematic Cube_8x8x8_LED_Base.sch]

Parts:
JP1, JP2, JP3, JP4, JP5, JP6, JP7, JP8, JP9, JP10, JP11, JP12, JP13, JP14, JP15, JP16, JP17, JP18, JP19, JP20, JP21, JP22, JP23, JP24, JP25, JP26, JP27, JP28, JP29, JP30, JP31, JP32, JP33, JP34, JP35, JP36, JP37, JP38, JP39, JP40, JP41, JP42, JP43, JP44, JP45, JP46, JP47, JP48, JP49, JP50, JP51, JP52, JP53, JP54, JP55, JP56, JP57, JP58, JP59, JP60, JP61, JP62, JP63, JP64, JP65, JP66, JP67, JP68, JP69, JP70, JP71, JP72: PINHD-1X1; 1X01
JP73, JP74, JP75, JP76: PINHD-1X16; 2X16
JP77, JP78: PINHEAD1X4; 2X04

Connections:
LAYER_1: JP65.1, JP77.1
LAYER_2: JP66.1, JP77.2
LAYER_3: JP67.1, JP77.3
LAYER_4: JP68.1, JP77.4
LAYER_5: JP69.1, JP78.1
LAYER_6: JP70.1, JP78.2
LAYER_7: JP71.1, JP78.3
LAYER_8: JP72.1, JP78.4
LED_1: JP1.1, JP73.1
LED_2: JP2.1, JP73.2
LED_3: JP3.1, JP73.3
LED_4: JP4.1, JP73.4
LED_5: JP5.1, JP73.5
LED_6: JP6.1, JP73.6
LED_7: JP7.1, JP73.7
LED_8: JP8.1, JP73.8
LED_9: JP9.1, JP73.9
LED_10: JP10.1, JP73.10
LED_11: JP11.1, JP73.11
LED_12: JP12.1, JP73.12
LED_13: JP13.1, JP73.13
LED_14: JP14.1, JP73.14
LED_15: JP15.1, JP73.15
LED_16: JP16.1, JP73.16
LED_17: JP17.1, JP74.1
LED_18: JP18.1, JP74.2
LED_19: JP19.1, JP74.3
LED_20: JP20.1, JP74.4
LED_21: JP21.1, JP74.5
LED_22: JP22.1, JP74.6
LED_23: JP23.1, JP74.7
LED_24: JP24.1, JP74.8
LED_25: JP25.1, JP74.9
LED_26: JP26.1, JP74.10
LED_27: JP27.1, JP74.11
LED_28: JP28.1, JP74.12
LED_29: JP29.1, JP74.13
LED_30: JP30.1, JP74.14
LED_31: JP31.1, JP74.15
LED_32: JP32.1, JP74.16
LED_33: JP33.1, JP75.1
LED_34: JP34.1, JP75.2
LED_35: JP35.1, JP75.3
LED_36: JP36.1, JP75.4
LED_37: JP37.1, JP75.5
LED_38: JP38.1, JP75.6
LED_39: JP39.1, JP75.7
LED_40: JP40.1, JP75.8
LED_41: JP41.1, JP75.9
LED_42: JP42.1, JP75.10
LED_43: JP43.1, JP75.11
LED_44: JP44.1, JP75.12
LED_45: JP45.1, JP75.13
LED_46: JP46.1, JP75.14
LED_47: JP47.1, JP75.15
LED_48: JP48.1, JP75.16
LED_49: JP49.1, JP76.1
LED_50: JP50.1, JP76.2
LED_51: JP51.1, JP76.3
LED_52: JP52.1, JP76.4
LED_53: JP53.1, JP76.5
LED_54: JP54.1, JP76.6
LED_55: JP55.1, JP76.7
LED_56: JP56.1, JP76.8
LED_57: JP57.1, JP76.9
LED_58: JP58.1, JP76.10
LED_59: JP59.1, JP76.11
LED_60: JP60.1, JP76.12
LED_61: JP61.1, JP76.13
LED_62: JP62.1, JP76.14
LED_63: JP63.1, JP76.15
LED_64: JP64.1, JP76.16

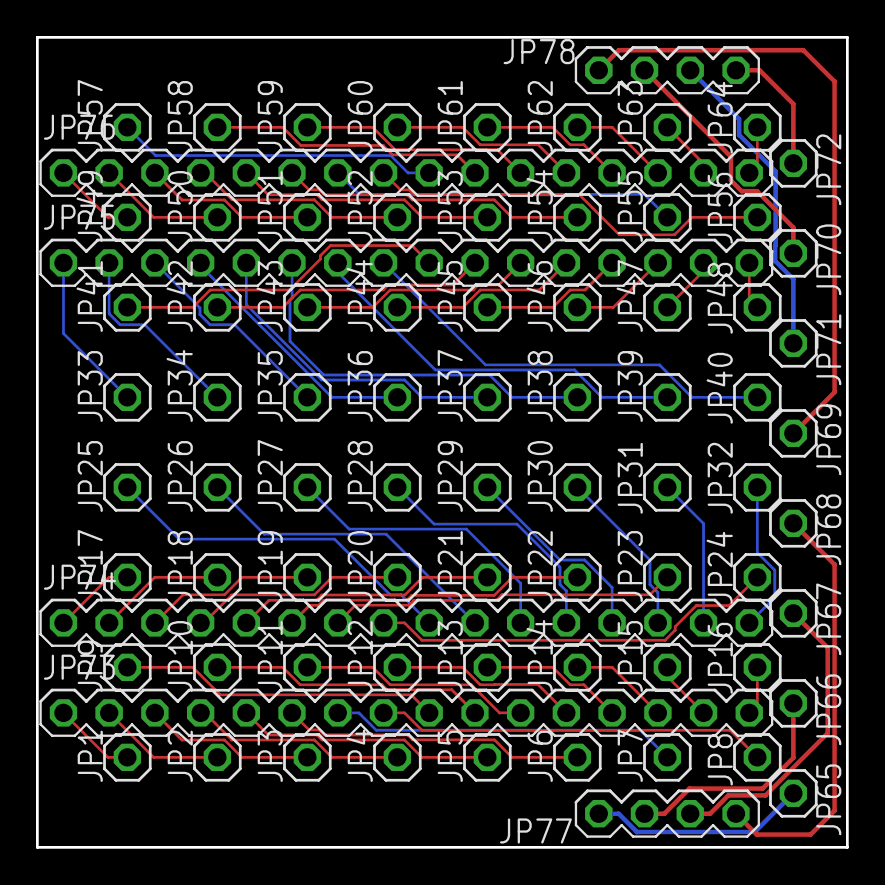
[picture p17: board Cube_8x8x8_LED_Base.brd from above]

Board: 2 copper layers, 45.0 x 45.0 mm, 78 parts (0 on the bottom side), 72 nets.
