ALumineMotus/LED_Cube_8x8x8_Mini/(commit log)

2024-01-14 Add project
    [Cube8_Mini_8x8x8_LED_Grid_08.brd, Cube_8x8x8_LED_Base.brd, Cube_8x8x8_LED_Base.sch, Cube_8x8x8_Mini_Control.brd, Cube_8x8x8_Mini_Control.sch, Cube_Mini_8x8x8_LED_Grid_08.sch, Cube_Mini_8x8x8_LED_Grid_top_bom_NH-B1010RGBT-HF.csv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]
2024-05-30 Update board and components
    [Cube_8x8x8_Mini_Control.brd, Cube_8x8x8_Mini_Control.sch, Cube_Mini_8x8x8_LED_Grid_08.brd, DRILEGEND.CFG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]
